dvhart/scad-models/README.md

## Overview
This repository contains a collection of 3D models for 3D printing or CNC.
Unless stated otherwise, these models were created using
[OpenSCAD](http://www.openscad.org).

## Models
group-collar-insert-gen1
: An experimental model of an espresso machine group collar insert inspired by
the Breville (r) line of espresso machines.

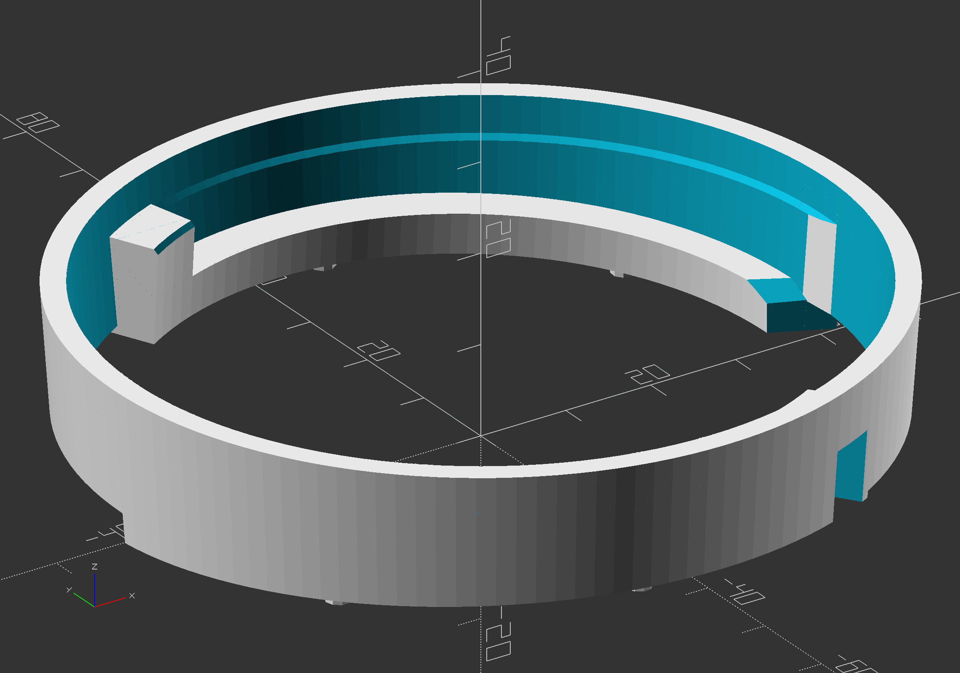
[picture p1: docs/assets/images/group-collar-insert-gen1.png]
Model Screenshot Initial screenshot of the early model

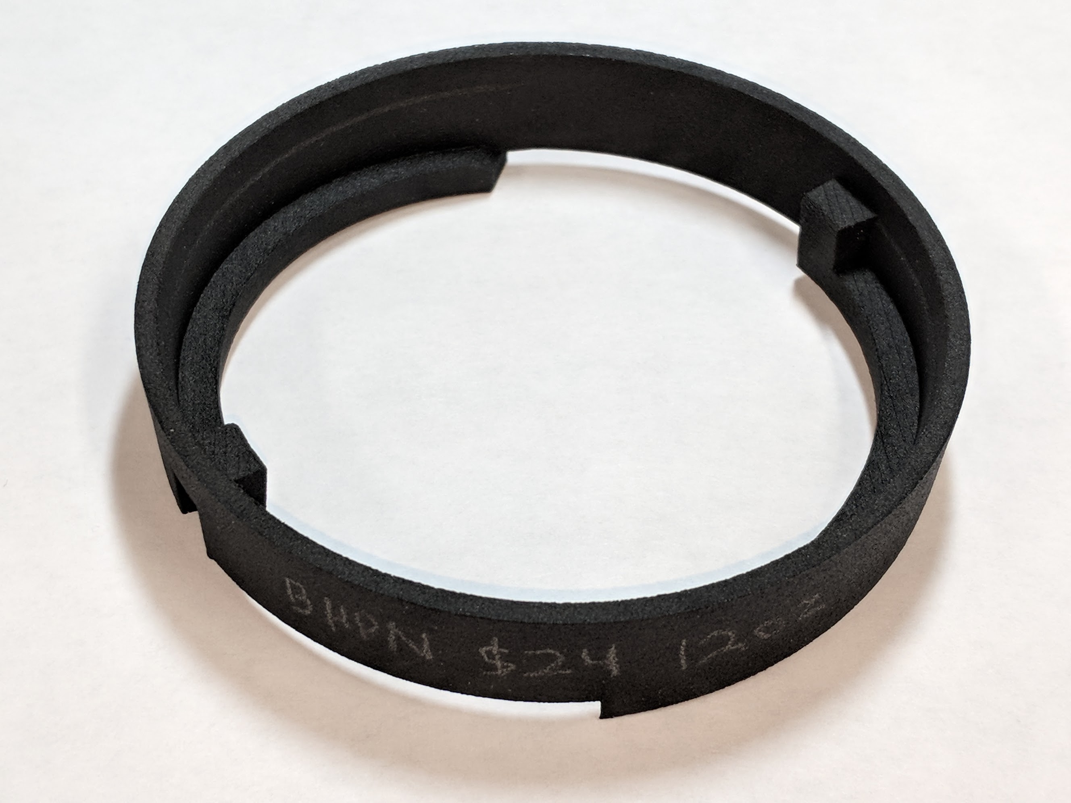
[picture p2: docs/assets/images/group-collar-insert-gen1-shapeways-hp-nylon.jpg]
Model Print v0.5 Shapeways print in Black HP Nylon Plastic


## License
The scad-models project is released under the terms of the
[BSD 2-Clause "Simplified" License](http://www.opensource.org/licenses/BSD-2-Clause):

Copyright (c) 2018, Darren Hart<br/>
All rights reserved.

Redistribution and use in source and binary forms, with or without modification,
are permitted provided that the following conditions are met:

1. Redistributions of source code must retain the above copyright notice, this
   list of conditions and the following disclaimer.

2. Redistributions in binary form must reproduce the above copyright notice,
   this list of conditions and the following disclaimer in the documentation
   and/or other materials provided with the distribution.

THIS SOFTWARE IS PROVIDED BY THE COPYRIGHT HOLDERS AND CONTRIBUTORS "AS IS" AND
ANY EXPRESS OR IMPLIED WARRANTIES, INCLUDING, BUT NOT LIMITED TO, THE IMPLIED
WARRANTIES OF MERCHANTABILITY AND FITNESS FOR A PARTICULAR PURPOSE ARE
DISCLAIMED. IN NO EVENT SHALL THE COPYRIGHT HOLDER OR CONTRIBUTORS BE LIABLE FOR
ANY DIRECT, INDIRECT, INCIDENTAL, SPECIAL, EXEMPLARY, OR CONSEQUENTIAL DAMAGES
(INCLUDING, BUT NOT LIMITED TO, PROCUREMENT OF SUBSTITUTE GOODS OR SERVICES;
LOSS OF USE, DATA, OR PROFITS; OR BUSINESS INTERRUPTION) HOWEVER CAUSED AND ON
ANY THEORY OF LIABILITY, WHETHER IN CONTRACT, STRICT LIABILITY, OR TORT
(INCLUDING NEGLIGENCE OR OTHERWISE) ARISING IN ANY WAY OUT OF THE USE OF THIS
SOFTWARE, EVEN IF ADVISED OF THE POSSIBILITY OF SUCH DAMAGE.

## Disclaimer
Unless otherwise stated, the models have been independently developed and imply
no association with manufacturers of similar parts.
