dvhart/scad-models/group-collar-insert-gen1.stl

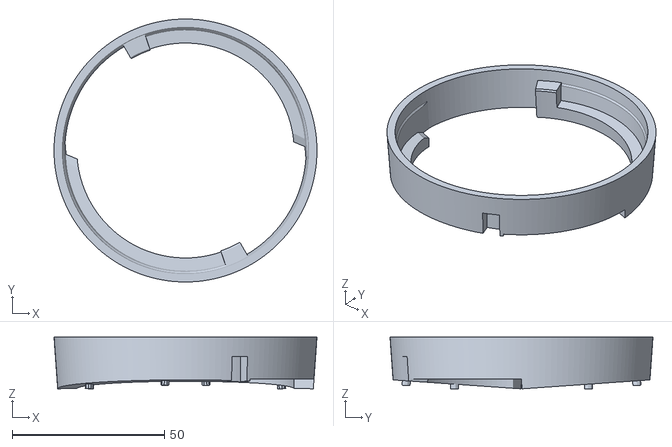
[picture p3: CAD file, 2018-01-14]
group-collar-insert-gen1.stl
86.4 x 86.4 x 17.0
