dvhart/scad-models/(commit log)

2018-01-07 Initial commit
    Add the initial model and BSD-2 License file.
    [group-collar-insert-gen1.scad, group-collar-insert-gen1.stl]
2018-01-09 group-collar-insert: Add relief and reduce width of stops
    The stops started a bit too early along the ramp, reduce by 1 degree.
    Add reliefs to the back side of the stops to allow the part to seat on
    the larger alignment blocks in the group head.
    [group-collar-insert-gen1.scad, group-collar-insert-gen1.stl]
2018-01-09 group-collar-insert: Refine fragment minimums
    The use of minimum fragment count ($fn) appears to be best used as a
    last resort per the manual.
    Use minimum fragment angle ($fa) for the larger rotations and reduce
    minimum fragment size for the alignment pins.
    [group-collar-insert-gen1.scad, group-collar-insert-gen1.stl]
2018-01-09 Update screenshot per current model
2018-01-13 group-collar-insert: Adjust stops and reliefs
    Based on physical measurements after the second 3D print samples, narrow
    the stops and the stop reliefs, starting them 2 degrees later and
    stopping at the same angle.
    [group-collar-insert-gen1.scad, group-collar-insert-gen1.stl]
2018-01-13 group-collar-insert: Bevel the ramp and fade the thicker walls
    Refine the model by beveling the start of the ramp as well as fading the
    thicker walls into the outer wall.
    This more closely resembles to original, and makes it easier to align
    the porta-filter during use.
    [group-collar-insert-gen1.scad, group-collar-insert-gen1.stl]
2018-01-13 docs: Update group-collar-insert screenshot
    Update the screenshot to the third version, including narrowd stops,
    beveled ramps, and smoothed inner walls.
2018-01-14 group-collar-insert: Parametertize construction
    Per Michael K. Johnson's recommendation [1], create pre-calculated
    variables and use them throughout construction. This makes it easier to
    read the code and to make consistent modifications. It also highlights
    where magic numbers are used, making them more obvious.
    1. https://plus.google.com/+DarrenHart/posts/NwW8YyRmnKR
    [group-collar-insert-gen1.scad, group-collar-insert-gen1.stl]
2018-01-14 group-collar-insert: Correct stretched funnel
    Two locations used a z-stretched funnel, presumably to avoid the shared
    plane shearing effect in preview mode. This resulted in distortion of
    the inner wall and ramp walls as the diameter variables weren't adjusted
    to compensate for the additional height.
    Correct this by using the height corresponding to the measured
    diameters, and add an element to the difference group to clear the
    shared plane (sized to have no impact on the model itself). Update the
    ramp bevel and ramp wall fading to account for the funnel changes.
    [group-collar-insert-gen1.scad, group-collar-insert-gen1.stl]
2018-01-14 group-collar-insert: Bevel ramp wall and stop
    Clean up the geometry a bit by beveling the top of the ramp wall and
    upper inside corner of the stop.
    [group-collar-insert-gen1.scad, group-collar-insert-gen1.stl]
2018-01-14 group-collar-insert: Example method to print version
    Experimental method to engrave the version in the print. Commented out
    for now.
    [group-collar-insert-gen1.scad]
2018-01-14 group-collar-insert: Add whitespace around operators
    [group-collar-insert-gen1.scad]
2018-01-14 group-collar-insert: Minor increase in funnel diameter
    Slightly increase the diameter of the funnel to be more consistent with
    measurements. Adjust the ramp bevel and ramp wall fade accordingly.
    Make the ramp bevel slightly less steep.
    Update model version to v0.5.
    [group-collar-insert-gen1.scad, group-collar-insert-gen1.stl]
2018-01-26 docs: Add photo of v0.5 Shapeways HP Nylon print
